twozero69/SHH2021_IGLODD_repository/source code/stm32/Core/Src/main.c

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
/* Includes ------------------------------------------------------------------*/
#include "main.h"

ADC_HandleTypeDef hadc1;

TIM_HandleTypeDef htim4;
TIM_HandleTypeDef htim5;

UART_HandleTypeDef huart4;

void SystemClock_Config(void);
static void MX_GPIO_Init(void);
static void MX_ADC1_Init(void);
static void MX_TIM4_Init(void);
static void MX_TIM5_Init(void);
static void MX_UART4_Init(void);
/* USER CODE BEGIN 0 */
int ADC_data13 = 0;
int ADC_data14 = 0;

int step=0;
int floor=0;
int direction=0;

int motorStep1[8]={0x09, 0x01, 0x03, 0x02, 0x06, 0x04, 0x0C, 0x08};	//GPIOC
int motorStep2[8]={0x20, 0x30, 0x10, 0x18, 0x08, 0x0C, 0x04, 0x24};	//GPIOA

uint8_t rxdata[2];

void HAL_TIM_PeriodElapsedCallback(TIM_HandleTypeDef *htim){
	  if(htim->Instance==TIM4){	//Motor
		  if(direction==1&&floor>0){	//down
			  GPIOC->ODR=motorStep1[step];
			  GPIOA->ODR=motorStep2[step];
			  step=(step+1)%8;
			  floor--;
		  }
		  else if(direction==2&&floor<13000){ //up
			  GPIOC->ODR=motorStep1[step];
			  GPIOA->ODR=motorStep2[step];
			  step=(step+7)%8;
			  floor++;
		  }
		  else{
			  GPIOA->BRR=0x3C;
			  GPIOC->BRR=0x0F;
		  }
	  }
	  if(htim->Instance==TIM5){	//Sensor
		  HAL_ADC_Start(&hadc1);
		  HAL_ADC_PollForConversion(&hadc1,100);
		  ADC_data13 = HAL_ADC_GetValue(&hadc1);

		  HAL_ADC_Start(&hadc1);
	 	  HAL_ADC_PollForConversion(&hadc1,100);
	  	  ADC_data14 = HAL_ADC_GetValue(&hadc1);

	  	  if(ADC_data13>3000)
	  		  direction=2;
	  	  else if(ADC_data14>3000)
	  		  direction=1;
	  	  else
	  		  direction=0;
	  }
  }

/* USER CODE END 0 */

/**
  * @brief  The application entry point.
  * @retval int
  */
int main(void)
{
  /* MCU Configuration--------------------------------------------------------*/

  /* Reset of all peripherals, Initializes the Flash interface and the Systick. */
  HAL_Init();

  /* Configure the system clock */
  SystemClock_Config();

  /* Initialize all configured peripherals */
  MX_GPIO_Init();
  MX_ADC1_Init();
  MX_TIM4_Init();
  MX_TIM5_Init();
  MX_UART4_Init();
  /* USER CODE BEGIN 2 */
  HAL_TIM_Base_Start_IT(&htim4);
  HAL_TIM_Base_Start_IT(&htim5);
  /* USER CODE END 2 */

  /* Infinite loop */
  /* USER CODE BEGIN WHILE */
  while (1)
  {
    /* USER CODE END WHILE */

    /* USER CODE BEGIN 3 */
  }
  /* USER CODE END 3 */
}

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
