twozero69/SHH2021_IGLODD_repository/source code/stm32/IGLODDer.ioc

Mcu.UserName=STM32L4S5VITx
PA0.Signal=UART4_TX
PA1.Signal=UART4_RX
PA2.Signal=GPIO_Output
PA3.Signal=GPIO_Output
PA4.Signal=GPIO_Output
PA5.Signal=GPIO_Output
PC0.Signal=GPIO_Output
PC1.Signal=GPIO_Output
PC2.Signal=GPIO_Output
PC3.Signal=GPIO_Output
PC4.Signal=ADCx_IN13
PC5.Signal=ADCx_IN14
