twozero69/SHH2021_IGLODD_repository/12.19 워크숍과제/Src/main.c

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

/* Includes ------------------------------------------------------------------*/
#include "main.h"

UART_HandleTypeDef huart3;

void SystemClock_Config(void);
static void MX_GPIO_Init(void);
static void MX_USART3_UART_Init(void);
/* USER CODE BEGIN 0 */

int _write(int file, char *ptr, int len)
{
	HAL_StatusTypeDef status = HAL_UART_Transmit(&huart3, (uint8_t*)ptr, len, 0xFFFF);
	return (status == HAL_OK? len:0);
}

int _read(int32_t file, uint8_t *result, int32_t len)
{
    HAL_StatusTypeDef status;
    int retcode = 0;

    if (len != 0) {
        status = HAL_UART_Receive( &huart3, (uint8_t *) result, len, HAL_MAX_DELAY);

        if (status == HAL_OK) {
            retcode = len;
        } else {
            retcode = -1;
        }
    }
    return(retcode);
}

/* USER CODE END 0 */

/**
  * @brief  The application entry point.
  * @retval int
  */
int main(void)
{
  /* MCU Configuration--------------------------------------------------------*/

  /* Reset of all peripherals, Initializes the Flash interface and the Systick. */
  HAL_Init();

  /* Configure the system clock */
  SystemClock_Config();

  /* Initialize all configured peripherals */
  MX_GPIO_Init();
  MX_USART3_UART_Init();
  /* USER CODE BEGIN 2 */
  setvbuf(stdin, NULL, _IONBF, 0);
  int num;
  /* USER CODE END 2 */

  /* Infinite loop */
  /* USER CODE BEGIN WHILE */
  while (1)
  {
    /* USER CODE END WHILE */
	  printf("please type only number.\r\n");
	  scanf("%d", &num);
	  printf("number is %d.\r\n", num);
    /* USER CODE BEGIN 3 */
  }
  /* USER CODE END 3 */
}

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
