twozero69/SHH2021_IGLODD_repository/(notices)

Notices in the files:
실습과제/12.19 워크숍과제/Src/main.c:
COPYRIGHT(c) 2020 STMicroelectronics
(C) COPYRIGHT STMicroelectronics *****END OF FILE
source code/stm32/Core/Src/main.c:
© Copyright (c) 2020 STMicroelectronics.
All rights reserved.
This software component is licensed by ST under BSD 3-Clause license,
the "License"; You may not use this file except in compliance with the
License. You may obtain a copy of the License at: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
